Givenplane/Double-Position-Kayak-Seat-Mount/docs/BOM.md

# Bill of materials

Components required for one complete set of four seat supports.

## Printed parts

| Part | Quantity | STL | STEP |
| --- | ---: | --- | --- |
| Front left support | 1 | [STL](../3d_models/STL/support-front-left.stl) | [STEP](../3d_models/STEP/support-front-left.step) |
| Front right support | 1 | [STL](../3d_models/STL/support-front-right.stl) | [STEP](../3d_models/STEP/support-front-right.step) |
| Rear left support | 1 | [STL](../3d_models/STL/support-back-left.stl) | [STEP](../3d_models/STEP/support-back-left.step) |
| Rear right support | 1 | [STL](../3d_models/STL/support-back-right.stl) | [STEP](../3d_models/STEP/support-back-right.step) |

## Hardware

| Component | Specification | Quantity |
| --- | --- | ---: |
| Hexagon socket head cap screw | M6 × 35 mm (TCEI) | 4 |
| Large-diameter flat washer | M6; outside diameter approximately 3 × hole diameter | 4 |
| O-ring | R19; stop between each front seat-foot upright and its support slide | 2 |

R19 is the supplied O-ring designation. Confirm its dimensions and material against the reference component before sourcing a substitute.
