Givenplane/Double-Position-Kayak-Seat-Mount/3d_models/STEP/support-back-left.step

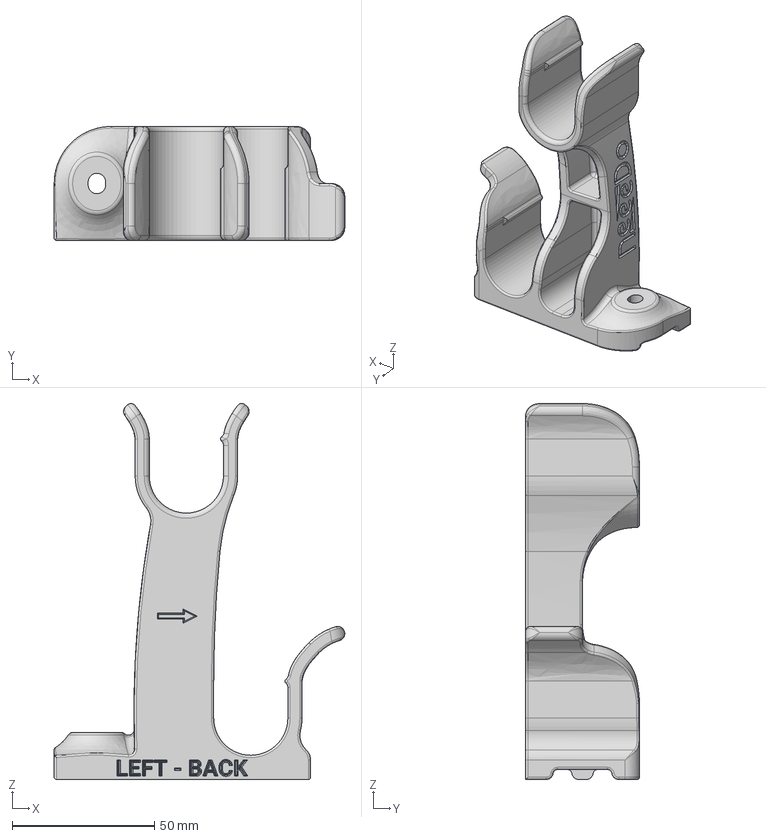
[picture p1: CAD file, 2026-10-16]
3d_models/STEP/support-back-left.step
102.0 x 40.0 x 132.0 mm
