Givenplane/Double-Position-Kayak-Seat-Mount/3d_models/STEP/support-front-left.step

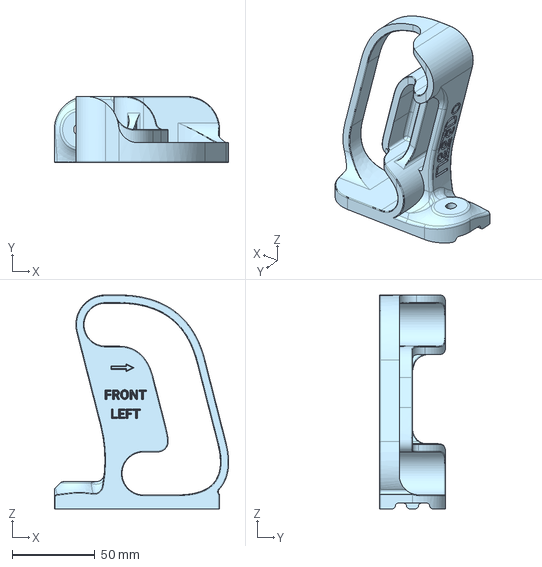
[picture p2: CAD file, 2026-10-16]
3d_models/STEP/support-front-left.step
105.5 x 40.0 x 129.5 mm
