Givenplane/Double-Position-Kayak-Seat-Mount/(list of files, cad)

Other CAD files:
3d_models/STEP/support-front-right.step
3d_models/STEP/support-back-right.step
3d_models/STL/support-back-left.stl
3d_models/STL/support-back-right.stl
3d_models/STL/support-front-left.stl
3d_models/STL/support-front-right.stl
