Givenplane/Double-Position-Kayak-Seat-Mount/docs/design_and_assembly.md

# Design and assembly

## Design overview

Four individual supports mount a commercially available kayak seat at two selectable seating heights. The set comprises a front left, front right, rear left and rear right support. Compatibility depends on the seat frame, feet and kayak mounting arrangement; the video demonstrates one reference installation.

The two R19 O-rings fit on the front seat-foot uprights. They act as stops between those uprights and the slides in the two front supports.

## Parts and tools

- One of each printed support: see the [bill of materials](BOM.md) for STL and STEP downloads.
- Four M6 × 35 mm hexagon socket head cap screws.
- Four M6 large-diameter flat washers (outside diameter approximately three times the hole diameter).
- Two R19 O-rings.
- A 5 mm hex key and a measuring tape.

Use one washer under each mounting screw head.

## Installation

### 1. Record the original seat position

Before removing the seat, measure its usual fore-and-aft position relative to the pedal assembly. Use this measurement when positioning the first front support.

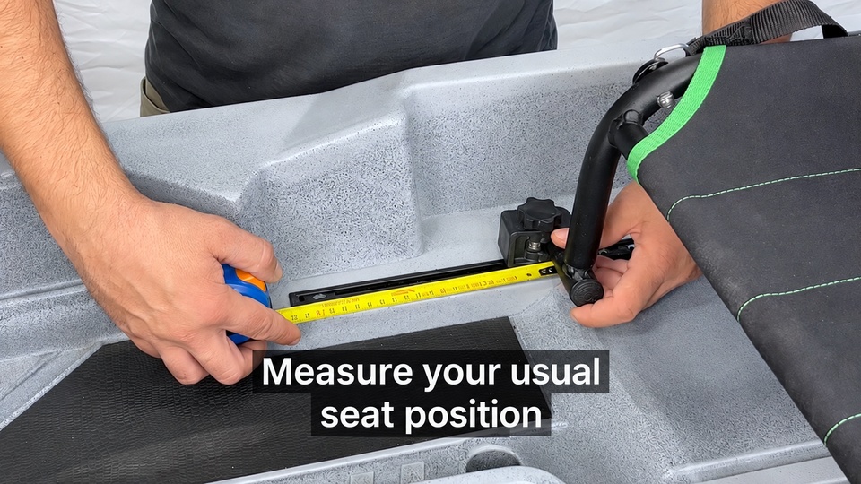
[picture p3: images/01-measure-seat-position.jpg]
Measure the original seat position relative to the pedals


### 2. Remove the original supports

Lift out the seat and remove the original fittings from its feet as shown in the reference installation.

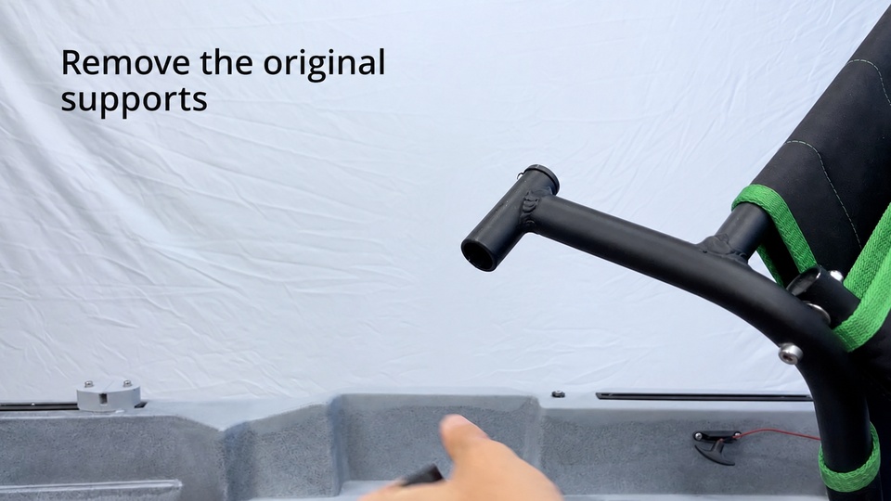
[picture p4: images/02-remove-original-supports.jpg]
Remove the original fittings from the seat feet


### 3. Fit the front O-rings

Slide one R19 O-ring onto each of the two front seat-foot uprights. Each ring forms a stop at the interface with its front support slide.

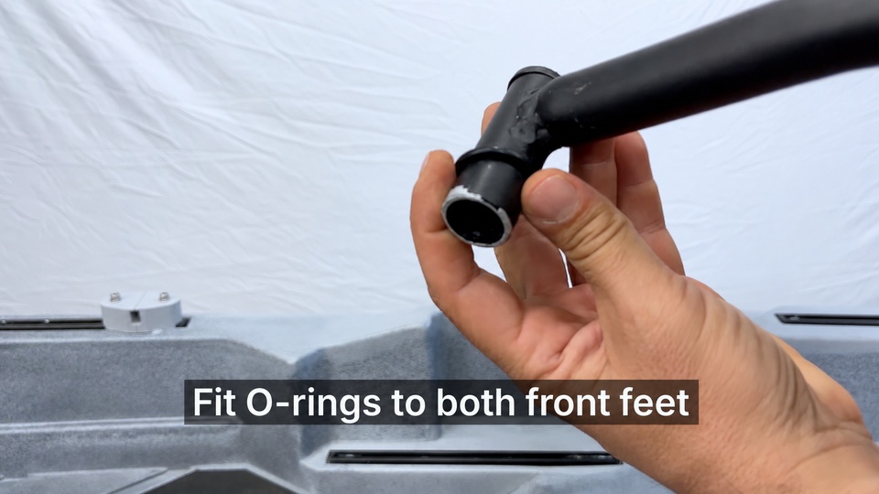
[picture p5: images/03-fit-front-o-rings.jpg]
Fit an O-ring onto each front seat-foot upright


### 4. Position and secure the first front support

Mount one front support on the kayak rail using an M6 × 35 mm screw, one M6 large-diameter washer under its head, and the appropriate rail attachment hardware. Adjust its distance from the pedal assembly using the measurement recorded in step 1.

The reference video specifies a 5 mm hex key and a maximum tightening torque of 5 Nm. This is the limit shown for that installation; do not exceed a lower limit specified for the actual rail or mounting hardware.

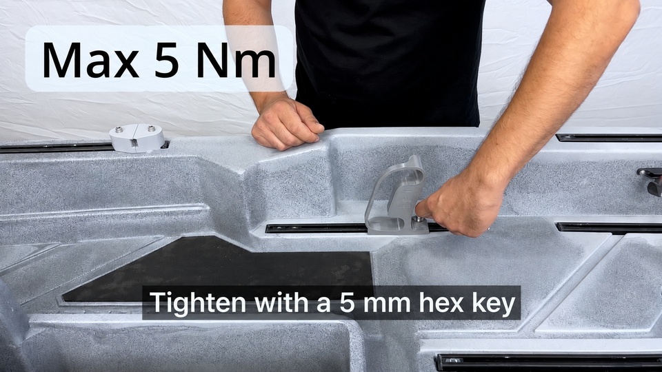
[picture p6: images/04-position-first-front-support.jpg]
First front support positioned on the rail; video specifies maximum 5 Nm


### 5. Align the second front support using the seat

Fit the second front support with its screw and washer, then place the seat in position to align it with the kayak and the opposite support. Secure the second support with the seat held in alignment.

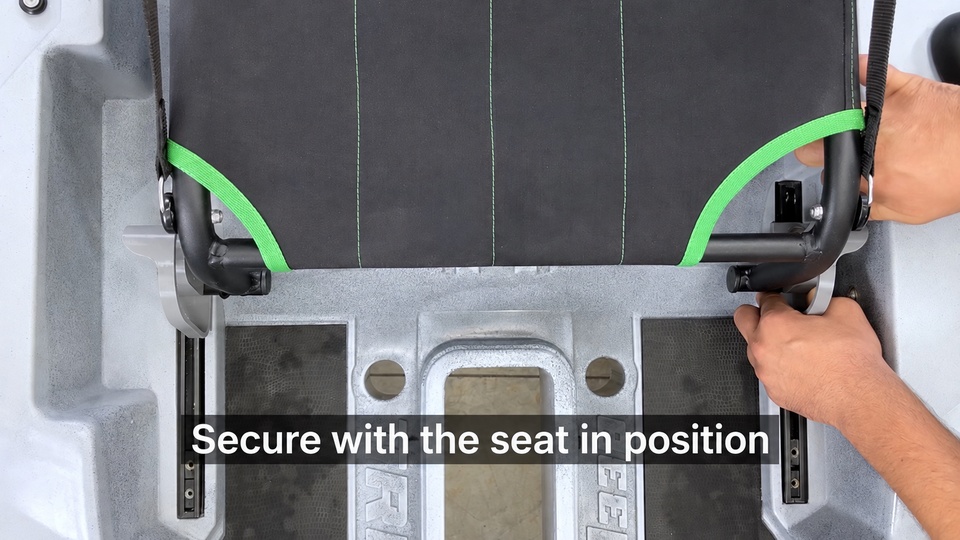
[picture p7: images/05-align-second-front-support.jpg]
Align and secure the second front support with the seat in position


### 6. Position the rear supports

Fit the rear supports to their rails with the remaining M6 × 35 mm screws and washers. Initially leave them loose enough to slide along the rails.

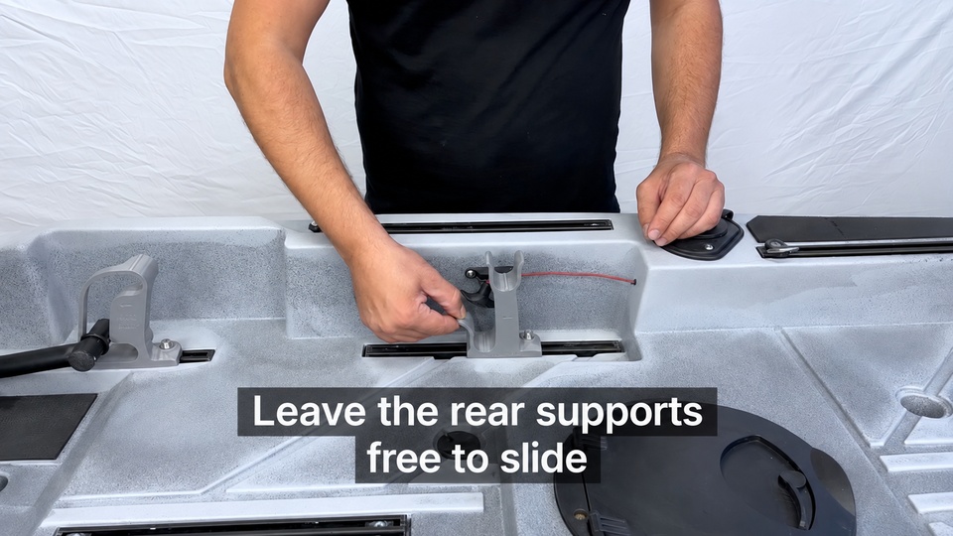
[picture p8: images/06-position-rear-supports.jpg]
Rear supports remain free to slide during positioning


Place the seat in position, slide the rear supports into alignment with the rear seat feet, then tighten with the seat in position.

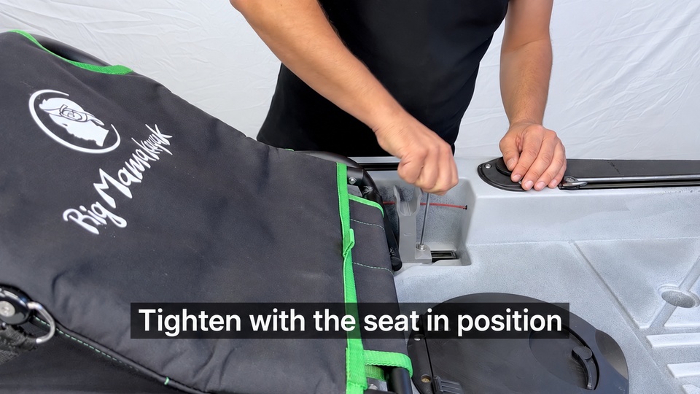
[picture p9: images/07-secure-rear-supports.jpg]
Secure the rear supports with the seat in position


## Inserting and removing the seat

Start with the seat tipped forward toward the bow. Guide one front foot and its O-ring into the corresponding front support, sliding them fully against the stop.

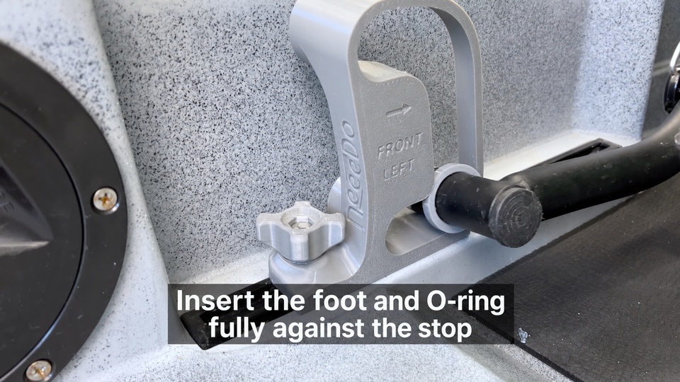
[picture p10: images/08-insert-front-seat-foot.jpg]
Front seat foot and O-ring fully inserted against the support stop


Angle the seat diagonally to pass the opposite front foot through the other support. The close-up below shows the foot passing through the support opening. Once both front feet are engaged, bring the seat back into its seating position and engage the rear feet in the corresponding rear seats.

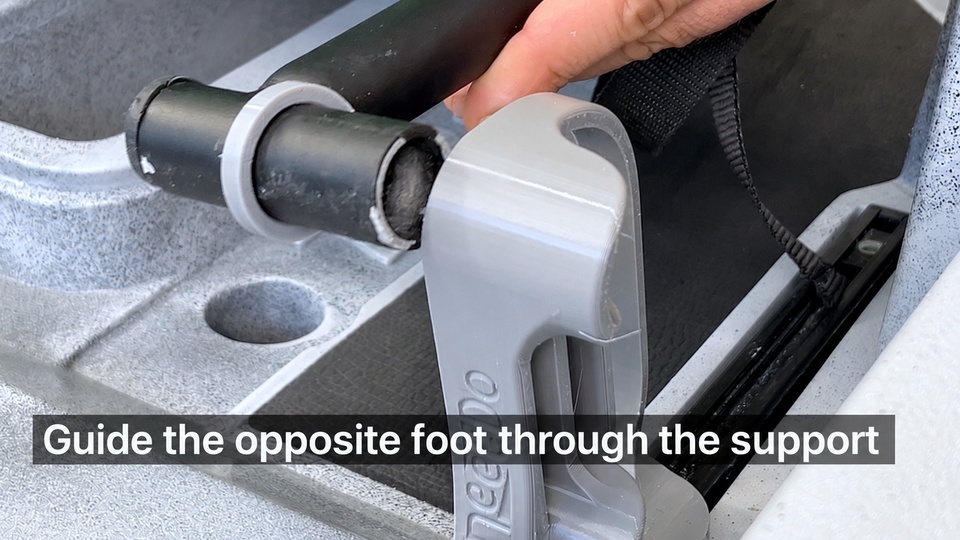
[picture p11: images/09-guide-opposite-seat-foot.jpg]
Guide the opposite front foot through the support opening


Remove the seat by reversing the insertion sequence.

## Two seating positions

The end of the video demonstrates the seat engaged in both the lower and raised positions. Check that all four feet are fully engaged in the corresponding support seats after repositioning.

### Lower position

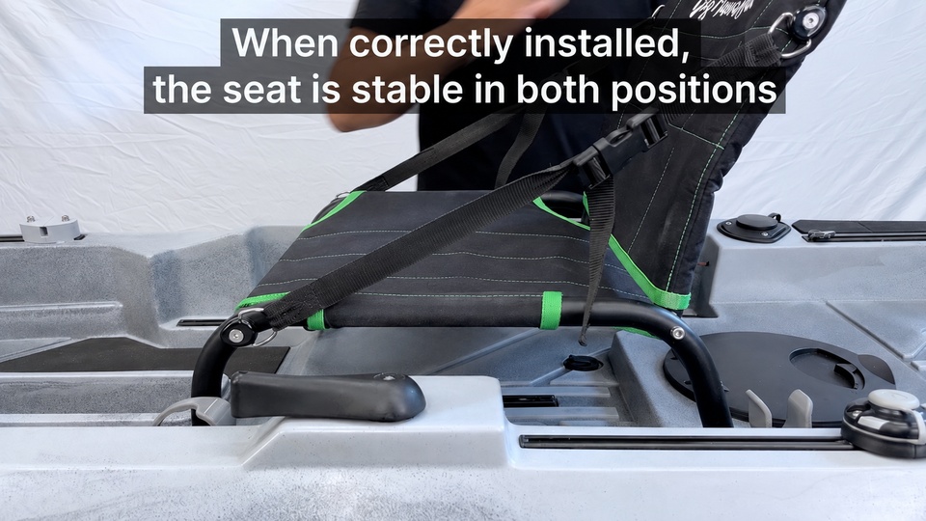
[picture p12: images/10-seat-lower-position.jpg]
Seat engaged in the lower position


### Raised position

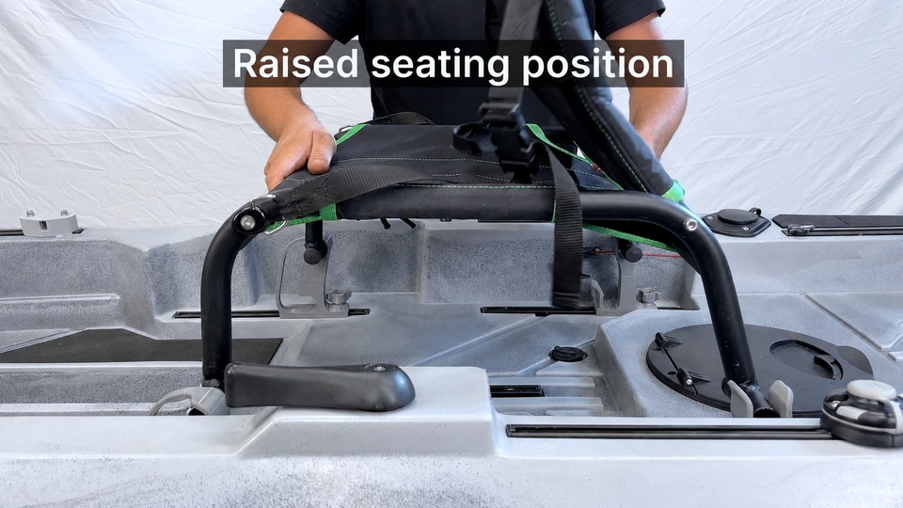
[picture p13: images/11-seat-raised-position.jpg]
Seat engaged in the raised position


## Documentation basis

Instructions and still images are based on the supplied installation video (approximately 00:12–01:08). The original Italian captions have been replaced with English translations using image editing. The still images illustrate the installation sequence.

Exact seat compatibility, mounting dimensions, height difference remain to be confirmed for the published CAD revision.

For material, infill and annealing recommendations, see [3D printing recommendations](../README.md#3d-printing-recommendations).
